elkel53930/extraice5/kicad/extraice/mainboard.dxf

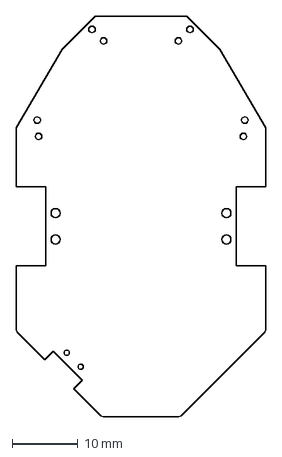
[picture p1: CAD file, 2024-08-13]
kicad/extraice/mainboard.dxf
38.0 x 61.0 mm
