elkel53930/extraice5/kicad/extraice/mainboard_position.dxf

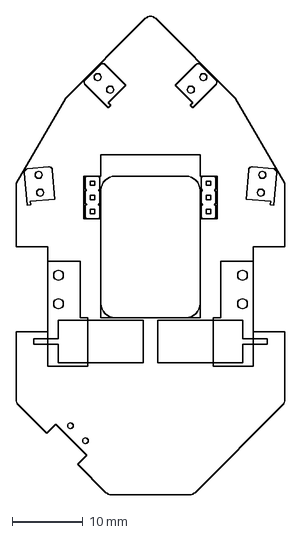
[picture p2: CAD file, 2024-08-13]
kicad/extraice/mainboard_position.dxf
38.0 x 67.6 mm
