elkel53930/extraice5/kicad/extraice/vacboard.dxf

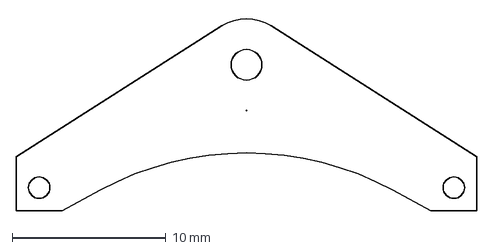
[picture p3: CAD file, 2024-08-13]
kicad/extraice/vacboard.dxf
30.0 x 12.7 mm
