elkel53930/extraice5/kicad/extraice/encoder.dxf

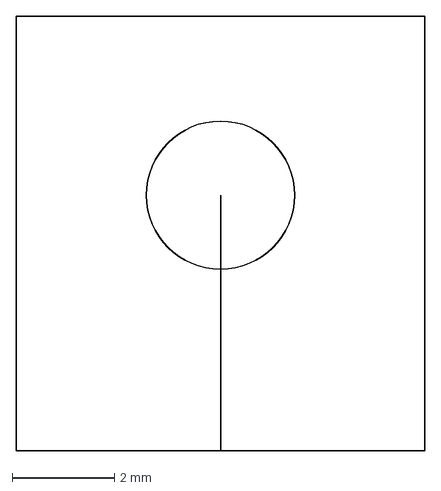
[picture p4: CAD file, 2024-08-13]
kicad/extraice/encoder.dxf
8.00 x 8.50 mm
