elkel53930/extraice5/kicad/extraice/extraice.pdf

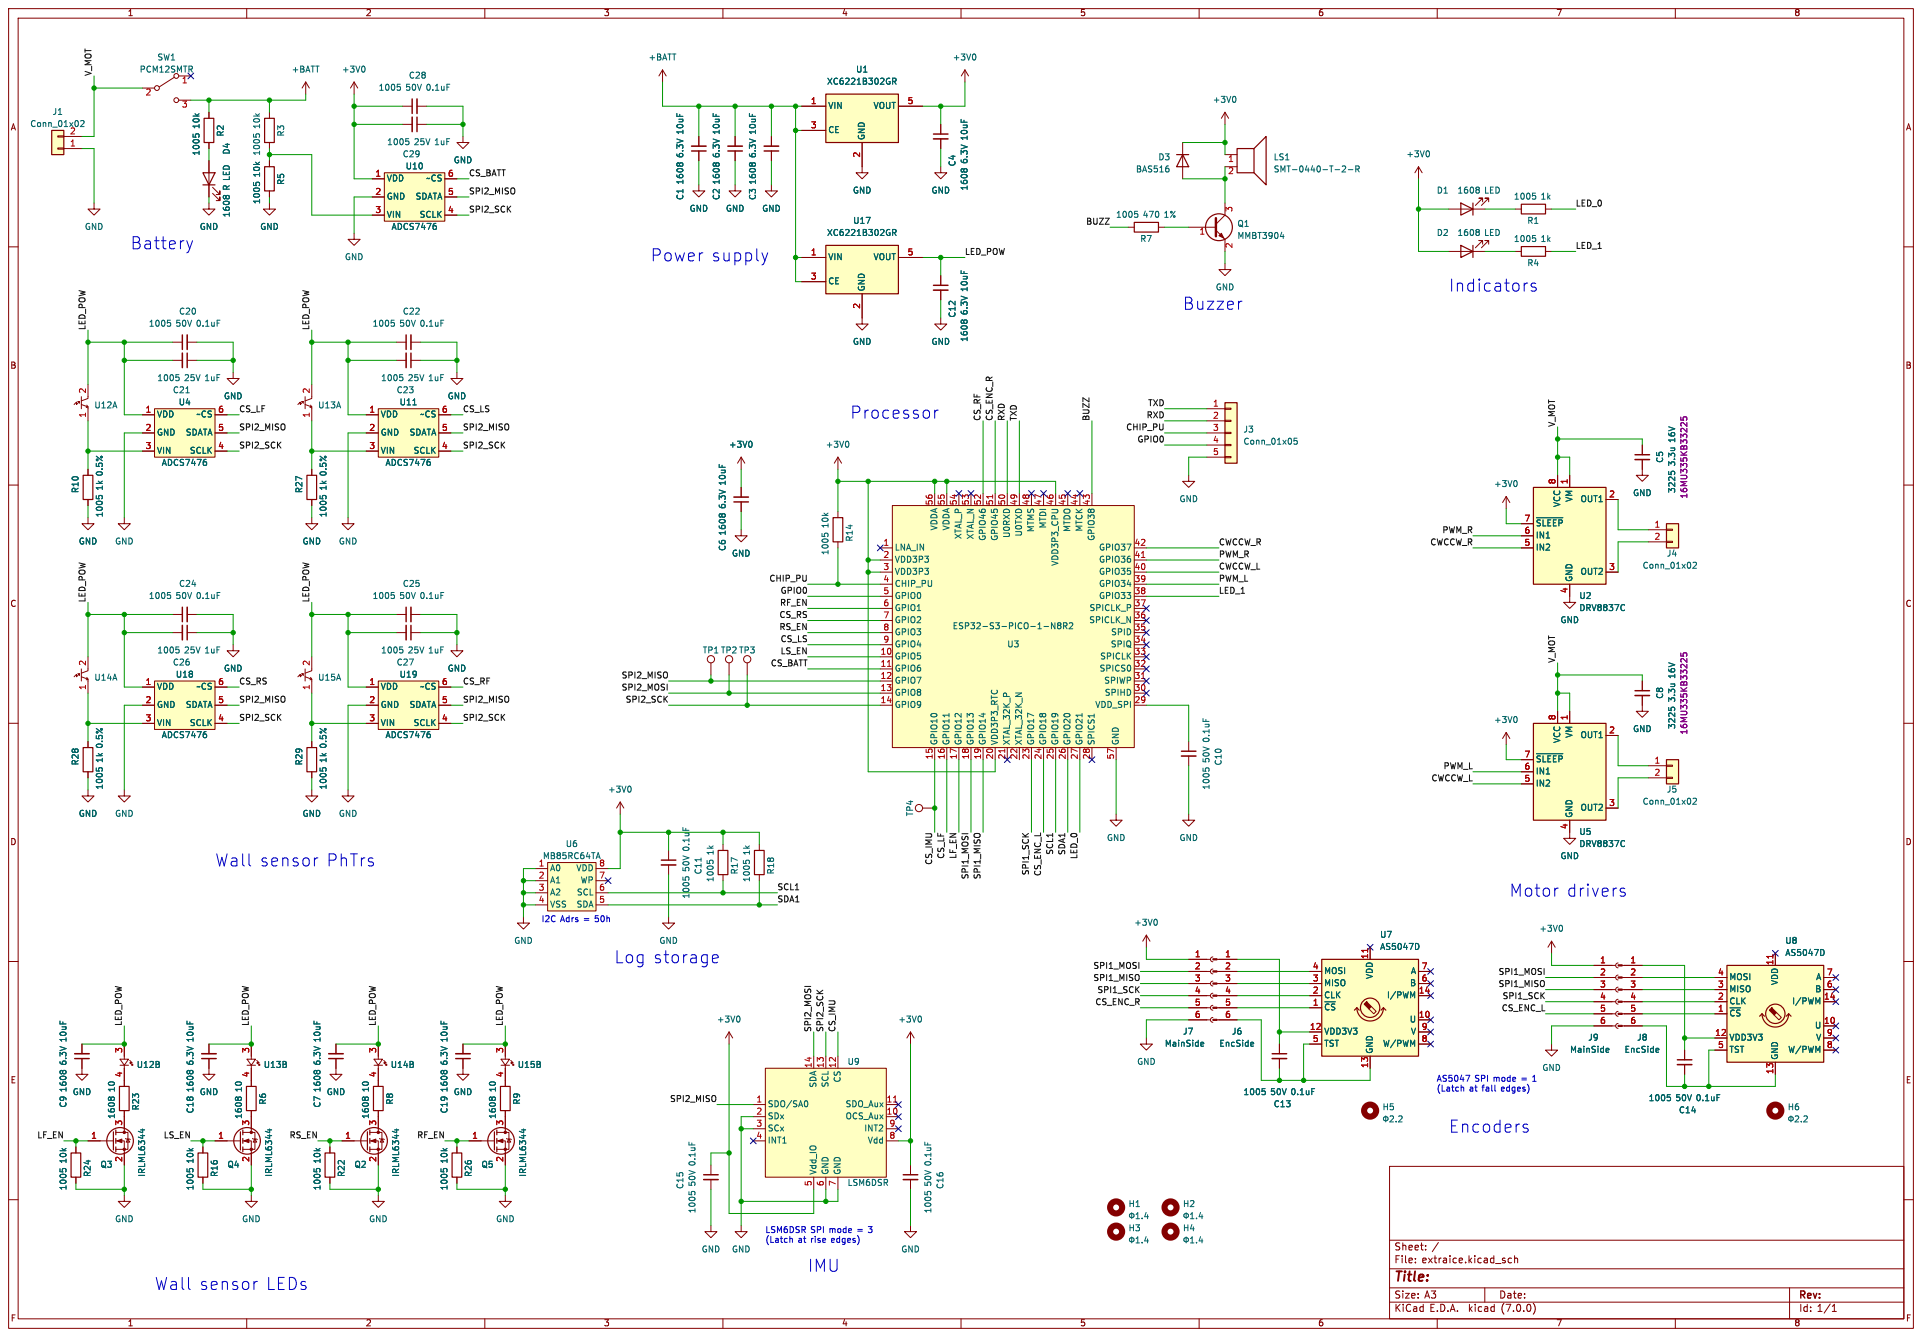
[picture p5: page 1]

2 CE 3 VOUT 5 GND C4 1608 6.3V 10uF GND GND GND GND U19 ADCS7476 VDD 1 GND 2 VIN 3 SCLK 4 SDATA 5 ~CS 6 GND R29 1005 1k 0.5%

LSM6DSR SPI mode = 3
(Latch at rise edges)
IMU

Id: 1/1 Title: File: extraice.kicad_sch Sheet: /
