elkel53930/extraice5/kicad/ifboard/ifboard/ifboard.kicad_pcb

## KiCad design kicad/ifboard/ifboard/ifboard.kicad_pcb (2024-08-13)

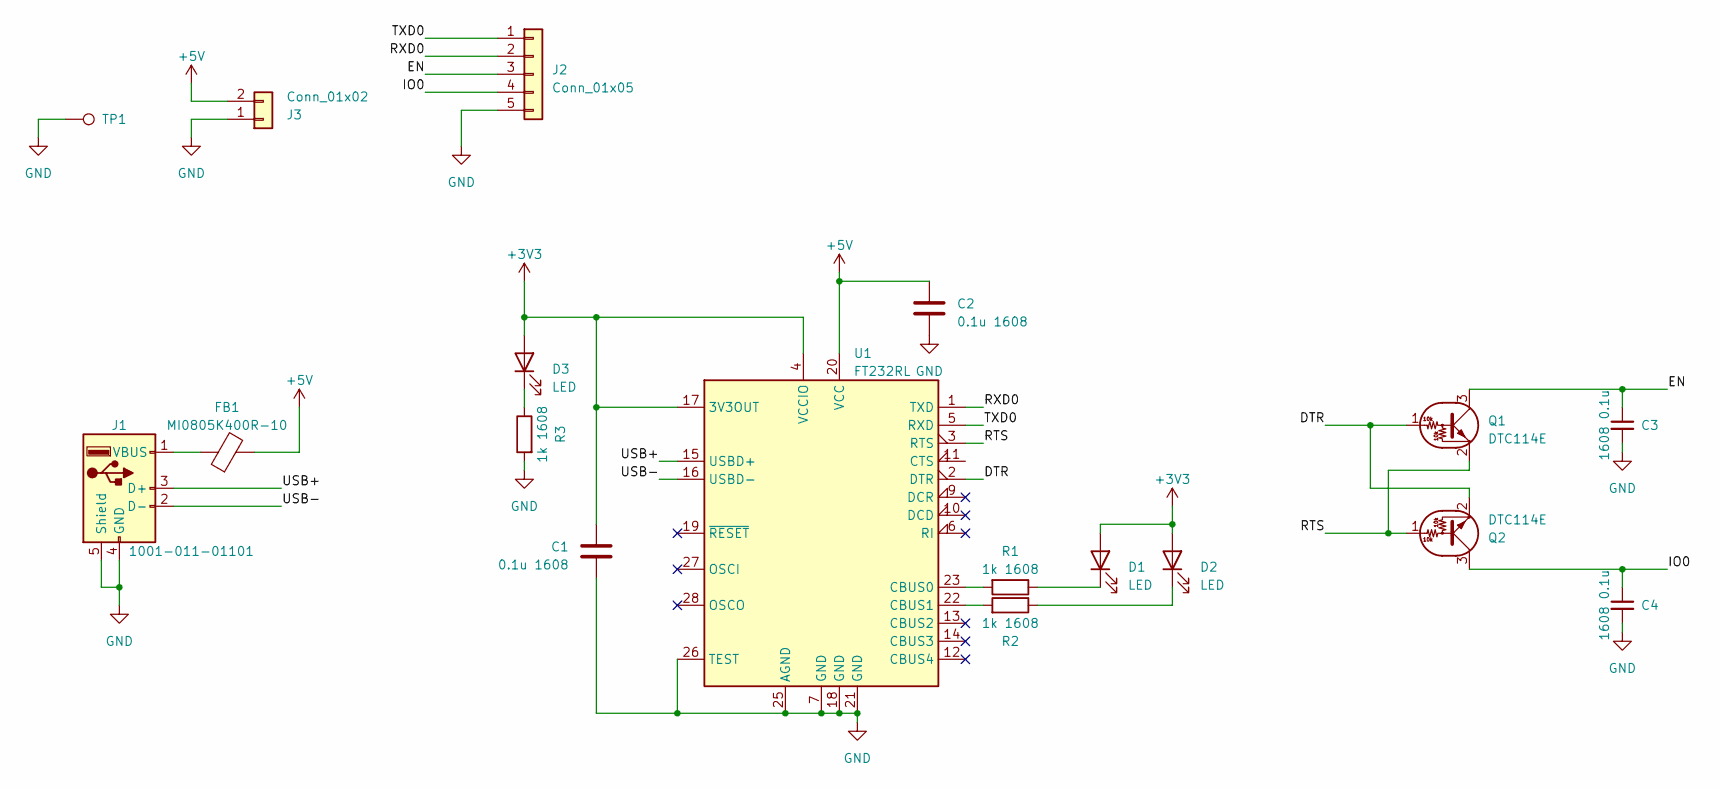
[picture p6: schematic ifboard.kicad_sch]

Parts:
C1, C2: 0.1u 1608; C_0603_1608Metric
C3, C4: 1608 0.1u; C_0603_1608Metric
D1, D2, D3: LED; LED_0603_1608Metric
FB1: MI0805K400R-10; C_0805_2012Metric
J1: 1001-011-01101; USB_A_CNCTech_1001-011-01101_Horizontal
J2: Conn_01x05; PinHeader_1x05_P2.00mm_Vertical
J3: Conn_01x02; PinHeader_1x02_P2.54mm_Vertical
Q1, Q2: DTC114E; SOT-723
R1, R2, R3: 1k 1608; R_0603_1608Metric
TP1: TestPoint_Loop_D2.50mm_Drill1.0mm
U1: FT232RL; SSOP-28_5.3x10.2mm_P0.65mm

Connections:
+3V3: C1.1, D1.2 (A), D2.2 (A), D3.2 (A), U1.4 (VCCIO), U1.17 (3V3OUT)
+5V: C2.1, FB1.2, J3.2, U1.20 (VCC)
/DTR: Q1.1 (B), Q2.2 (E), U1.2 (DTR)
/EN: C3.1, J2.3, Q1.3 (C)
/IO0: C4.1, J2.4, Q2.3 (C)
/RTS: Q1.2 (E), Q2.1 (B), U1.3 (RTS)
/RXD0: J2.2, U1.1 (TXD)
/TXD0: J2.1, U1.5 (RXD)
/USB+: J1.3 (D+), U1.15 (USBD+)
/USB-: J1.2 (D-), U1.16 (USBD-)
GND: C1.2, C2.2, C3.2, C4.2, J1.4 (GND), J1.5 (Shield), J2.5, J3.1, R3.2, TP1.1, U1.7 (GND), U1.18 (GND), U1.21 (GND), U1.25 (AGND), U1.26 (TEST)
unnamed: D1.1 (K), R1.1
unnamed: D2.1 (K), R2.1
unnamed: D3.1 (K), R3.1
unnamed: FB1.1, J1.1 (VBUS)
unnamed: R1.2, U1.23 (CBUS0)
unnamed: R2.2, U1.22 (CBUS1)

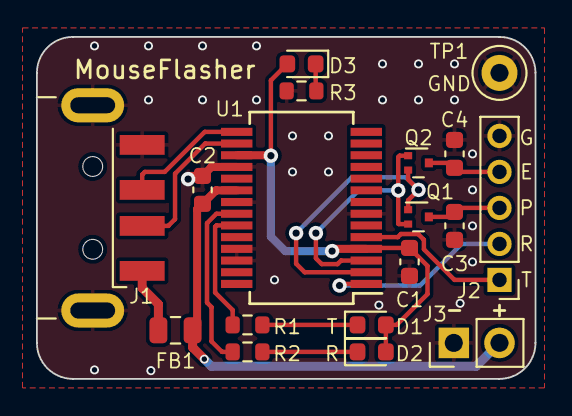
[picture p7: board ifboard.kicad_pcb from above]

Board: 2 copper layers, 27.7 x 19.0 mm, 18 parts (0 on the bottom side), 17 nets.
