elkel53930/extraice5/kicad/extraice/extraice.kicad_pcb

## KiCad design kicad/extraice/extraice.kicad_pcb (2024-08-13)

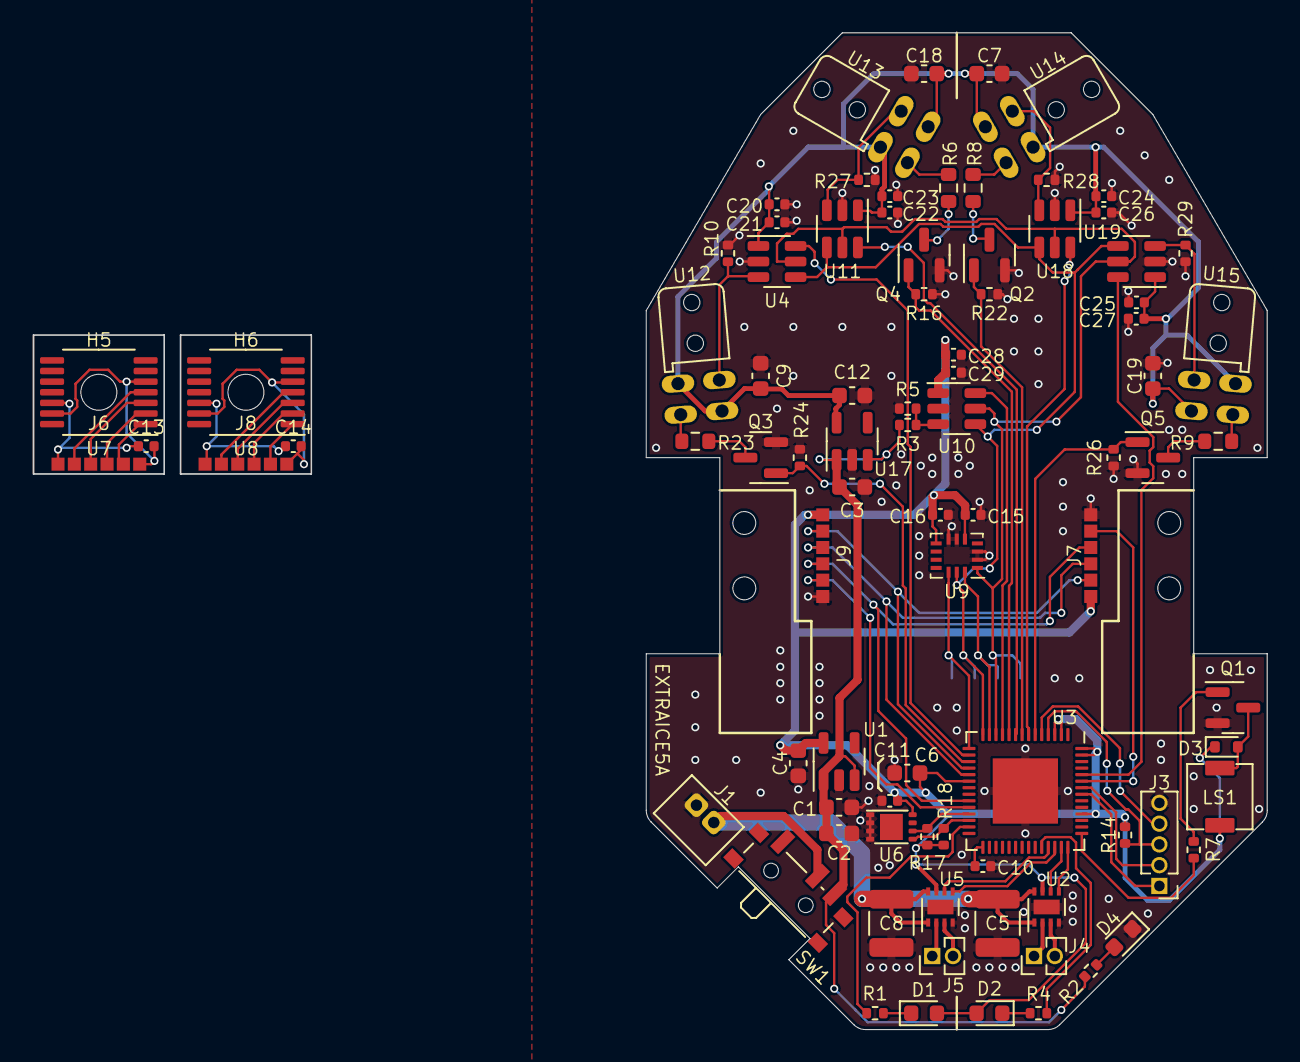
[picture p8: board extraice.kicad_pcb from above]

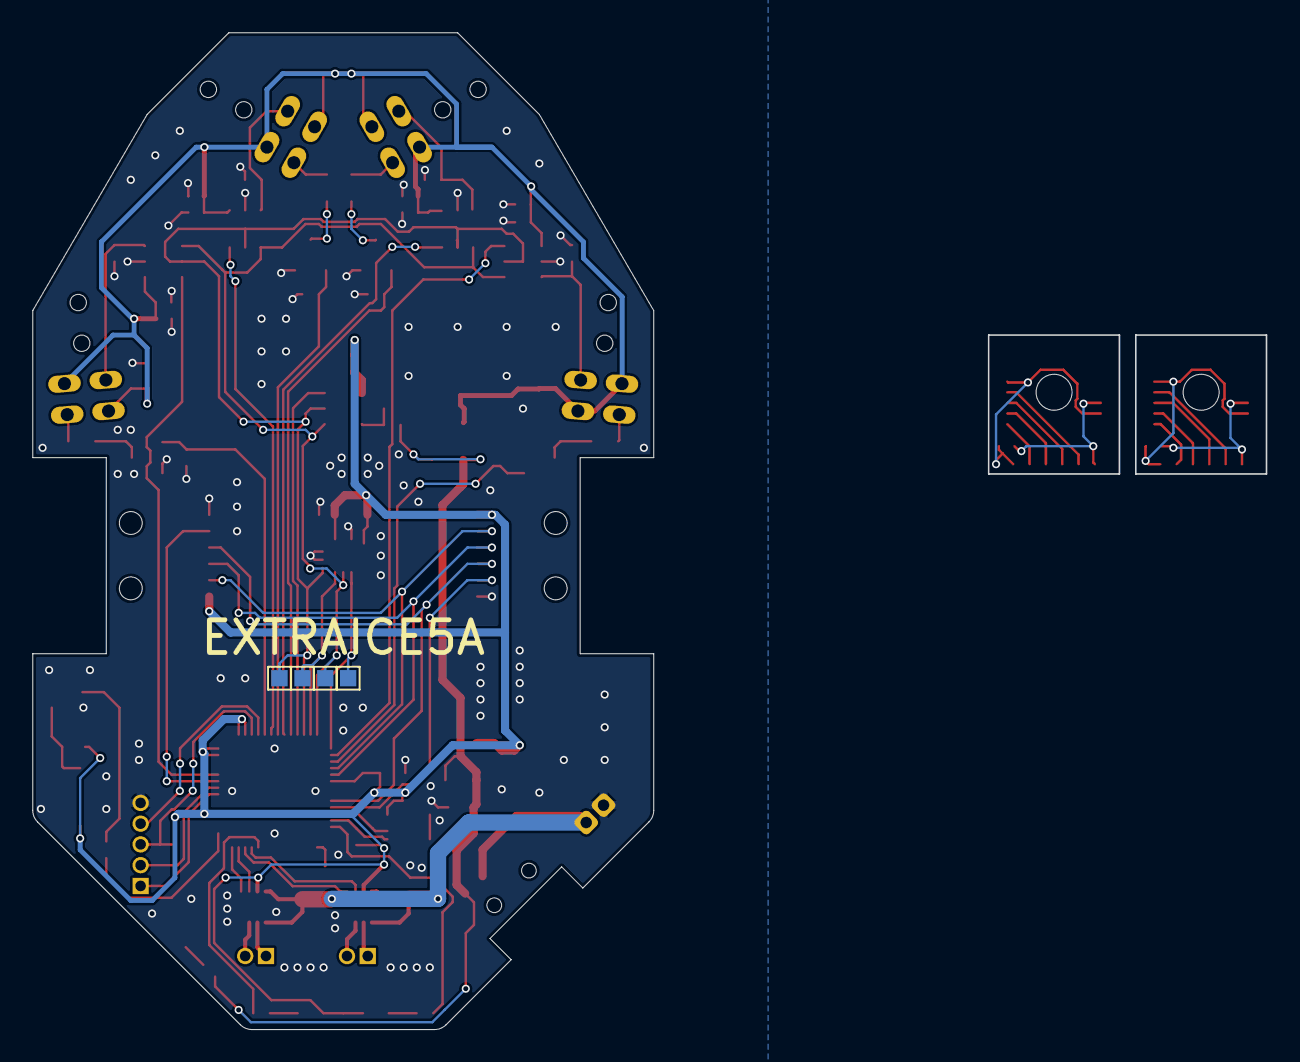
[picture p9: board extraice.kicad_pcb from below]

Board: 2 copper layers, 38.0 x 61.0 mm, 96 parts (4 on the bottom side), 71 nets.

Parts:
C1, C2, C3, C4, C6, C7, C9, C12, C18, C19: 1608 6.3V 10uF; C_0603_1608Metric
C5, C8: 3225 3.3u 16V; C_1210_3225Metric
C10, C11, C13, C14, C15, C16, C20, C22, C24, C25, C28: 1005 50V 0.1uF; C_0402_1005Metric
C21, C23, C26, C27, C29: 1005 25V 1uF; C_0402_1005Metric
D1, D2: 1608 LED; LED_0603_1608Metric
D3: BAS516; D_SOD-523
D4: 1608 R LED; LED_0603_1608Metric
H1, H2, H3, H4: Φ1.4; Hole1.4
H5, H6: Φ2.2; MountingHole_2.2mm_M2
J1: Conn_01x02; B2B-ZH
J3: Conn_01x05; PinHeader_1x05_P1.27mm_Vertical
J4, J5: Conn_01x02; PinHeader_1x02_P1.27mm_Vertical
J6, J8: EncSide; EncoderTerminal
J7, J9: MainSide; EncoderTerminal
LS1: SMT-0440-T-2-R
Q1: MMBT3904; SOT-23
Q2, Q3, Q4, Q5: IRLML6344; SOT-23
R1, R4, R17, R18: 1005 1k; R_0402_1005Metric
R2, R3, R5, R14, R16, R22, R24, R26: 1005 10k; R_0402_1005Metric
R6, R8, R9, R23: 1608 10; R_0603_1608Metric
R7: 1005 470 1%; R_0402_1005Metric
R10, R27, R28, R29: 1005 1k 0.5%; R_0402_1005Metric
SW1: PCM12SMTR; SW_SPDT_PCM12
TP1, TP2, TP3, TP4: TestPoint; TestPoint_Pad_1.0x1.0mm
U1, U17: XC6221B302GR; SOT-23-5
U2, U5: DRV8837C; WSON-8-1EP_2x2mm_P0.5mm_EP0.9x1.6mm
U3: ESP32-S3-PICO-1-N8R2; QFN-56-1EP_7x7mm_P0.4mm_EP4x4mm
U4, U10, U11, U18, U19: ADCS7476; SOT-23-6
U6: MB85RC64TA; LCC-8P-M04
U7, U8: AS5047D; TSSOP-14_4.4x5mm_P0.65mm
U9: LSM6DSR; Bosch_LGA-14_3x2.5mm_P0.5mm
U12, U13: PhotoSensorL
U14, U15: PhotoSensorR

Connections:
+3V0: C4.1, C6.2, C11.1, C15.1, C16.1, C28.1, C29.2, D1.2 (A), D2.2 (A), D3.1 (K), J7.1, J9.1, LS1.1, R14.2, R17.2, R18.2, U1.5 (VOUT), U2.7 (~SLEEP), U3.2 (VDD3P3), U3.3 (VDD3P3), U3.20 (VDD3P3_RTC), U3.46 (VDD3P3_CPU), U3.55 (VDDA), U3.56 (VDDA), U5.7 (~SLEEP), U6.8 (VDD), U9.5 (Vdd_IO), U9.8 (Vdd), U10.1 (VDD)
+BATT: C1.2, C2.2, C3.2, R2.2, R3.2, SW1.3 (C), U1.1 (VIN), U1.3 (CE), U17.1 (VIN), U17.3 (CE)
/BUZZ: R7.1, U3.43 (GPIO38)
/CHIP_PU: J3.3, R14.1, U3.4 (CHIP_PU)
/CS_BATT: U3.11 (GPIO6), U10.6 (~CS)
/CS_ENC_L: J9.5, U3.24 (GPIO18)
/CS_ENC_R: J7.5, U3.51 (GPIO45)
/CS_IMU: TP4.1, U3.15 (GPIO10), U9.12 (CS)
/CS_LF: U3.16 (GPIO11), U4.6 (~CS)
/CS_LS: U3.9 (GPIO4), U11.6 (~CS)
/CS_RF: U3.52 (GPIO46), U19.6 (~CS)
/CS_RS: U3.7 (GPIO2), U18.6 (~CS)
/CWCCW_L: U3.40 (GPIO35), U5.5 (IN2)
/CWCCW_R: U2.5 (IN2), U3.42 (GPIO37)
/GPIO0: J3.4, U3.5 (GPIO0)
/LED_0: R1.2, U3.27 (GPIO21)
/LED_1: R4.2, U3.38 (GPIO33)
/LED_POW: C7.2, C9.2, C12.1, C18.2, C19.2, C20.1, C21.2, C22.1, C23.2, C24.1, C25.1, C26.2, C27.2, U4.1 (VDD), U11.1 (VDD), U12.2, U12.3, U13.2, U13.3, U14.2, U14.3, U15.2, U15.3, U17.5 (VOUT), U18.1 (VDD), U19.1 (VDD)
/LF_EN: Q3.1 (G), R24.2, U3.17 (GPIO12)
/LS_EN: Q4.1 (G), R16.2, U3.10 (GPIO5)
/PWM_L: U3.39 (GPIO34), U5.6 (IN1)
/PWM_R: U2.6 (IN1), U3.41 (GPIO36)
/RF_EN: Q5.1 (G), R26.2, U3.6 (GPIO1)
/RS_EN: Q2.1 (G), R22.2, U3.8 (GPIO3)
/RXD: J3.2, U3.50 (U0RXD)
/SCL1: R17.1, U3.25 (GPIO19), U6.6 (SCL)
/SDA1: R18.1, U3.26 (GPIO20), U6.5 (SDA)
/SPI1_MISO: J7.3, J9.3, U3.19 (GPIO14)
/SPI1_MOSI: J7.2, J9.2, U3.18 (GPIO13)
/SPI1_SCK: J7.4, J9.4, U3.23 (GPIO17)
/SPI2_MISO: TP1.1, U3.12 (GPIO7), U4.5 (SDATA), U9.1 (SDO/SA0), U10.5 (SDATA), U11.5 (SDATA), U18.5 (SDATA), U19.5 (SDATA)
/SPI2_MOSI: TP2.1, U3.13 (GPIO8), U9.14 (SDA)
/SPI2_SCK: TP3.1, U3.14 (GPIO9), U4.4 (SCLK), U9.13 (SCL), U10.4 (SCLK), U11.4 (SCLK), U18.4 (SCLK), U19.4 (SCLK)
/TXD: J3.1, U3.49 (U0TXD)
/V_MOT: C5.1, C8.1, J1.2, SW1.2 (B), U2.1 (VM), U2.8 (VCC), U5.1 (VM), U5.8 (VCC)
GND: C1.1, C2.1, C3.1, C4.2, C5.2, C6.1, C7.1, C8.2, C9.1, C10.2, C11.2, C12.2, C15.2, C16.2, C18.1, C19.1, C20.2, C21.1, C22.2, C23.1, C24.2, C25.2, C26.1, C27.1, C28.2, C29.1, D4.1 (K), J1.1, J3.5, J7.6, J9.6, Q1.2 (E), Q2.2 (S), Q3.2 (S), Q4.2 (S), Q5.2 (S), R5.1, R10.2, R16.1, R22.1, R24.1, R26.1, R27.2, R28.2, R29.2, U1.2 (GND), U2.4 (GND), U2.9 (GND), U3.57 (GND), U4.2 (GND), U5.4 (GND), U5.9 (GND), U6.1 (A0), U6.2 (A1), U6.3 (A2), U6.4 (VSS), U9.2 (SDx), U9.3 (SCx), U9.6 (GND), U9.7 (GND), U10.2 (GND), U11.2 (GND), U17.2 (GND), U18.2 (GND), U19.2 (GND)
unnamed: D1.1 (K), R1.1
unnamed: D2.1 (K), R4.1
unnamed: D3.2 (A), LS1.2, Q1.3 (C)
unnamed: D4.2 (A), R2.1
unnamed: J4.1, U2.2 (OUT1)
unnamed: J4.2, U2.3 (OUT2)
unnamed: J5.1, U5.2 (OUT1)
unnamed: J5.2, U5.3 (OUT2)
unnamed: C13.1, J6.1, U7.12 (VDD3V3)
unnamed: J6.2, U7.4 (MOSI)
unnamed: J6.3, U7.3 (MISO)
unnamed: J6.4, U7.2 (CLK)
unnamed: J6.5, U7.1 (~CS)
unnamed: C13.2, J6.6, U7.5 (TST), U7.13 (GND)
unnamed: C14.1, J8.1, U8.12 (VDD3V3)
unnamed: J8.2, U8.4 (MOSI)
unnamed: J8.3, U8.3 (MISO)
unnamed: J8.4, U8.2 (CLK)
unnamed: J8.5, U8.1 (~CS)
unnamed: C14.2, J8.6, U8.5 (TST), U8.13 (GND)
unnamed: Q1.1 (B), R7.2
unnamed: Q2.3 (D), R8.1
unnamed: Q3.3 (D), R23.1
unnamed: Q4.3 (D), R6.1
unnamed: Q5.3 (D), R9.1
unnamed: R6.2, U13.4
unnamed: R8.2, U14.4
unnamed: R9.2, U15.4
unnamed: R23.2, U12.4
unnamed: C10.1, U3.29 (VDD_SPI)
unnamed: R10.1, U4.3 (VIN), U12.1
unnamed: R3.1, R5.2, U10.3 (VIN)
unnamed: R27.1, U11.3 (VIN), U13.1
unnamed: R28.1, U14.1, U18.3 (VIN)
unnamed: R29.1, U15.1, U19.3 (VIN)
